BerandaMegane/avr-isp-updi/(commit log)

2024-10-28 実物製作を反映
2024-11-02 説明追加
2024-11-02 ロジック図追加
